JuanMartin-Cruz/ESP32-grupo-1-Etapa2/docs/TPI-Etapa2-Grupo1-Presentación.pdf

UNIVERSIDAD TECNOLÓGICA NACIONAL FRCU
INGENIERÍA EN SISTEMAS DE INFORMACIÓN

# TPI Etapa 2 Mejora de Proyecto Aire IoT

# Tecnologías para la Automatización

ALUMNOS

### Allaud, Santiago Alvarez, Noemí Carballo Peré, María Florencia Cruz, Juan Martin Ramos, Alexander

DOCENTES

### Ing. Mauro Sander Dimuro Ing. Jaime Piperno

AÑO

2026 01

# El proyecto original "Aire IoT" monitorea la calidad del aire en interiores

DESCRIPCIÓN DEL SISTEMA RECIBIDO
Monitoreo ambiental con microcontrolador ESP32 y sensor BME680
El proyecto recibido consiste en un sistema de monitoreo ambiental enfocado en la medición y visualización de parámetros de calidad del aire. Estado de Entrega: Entregado en buenas condiciones, con todas sus funcionalidades operativas y funcionando correctamente.

VARIABLES

## Medición

- Estimación de la
calidad del aire

NOTIFICACIÓN

## Alertas Locales

- Utiliza un LED
- Buzzer integrado
- Notifica condiciones
desfavorables

VISUALIZACIÓN

## Interfaz Web

- Panel para visualizar
mediciones en
tiempo real
- Consulta de historial
- Exportación de
datos en formato
CSV

LIMITACIÓN

## Intervención Manual

- Funciona como un
sistema de alerta
pasiva
- Informa cuándo
ventilar
- Requiere la acción
de una persona
UTN FRCU INGENIERÍA EN SISTEMAS DE INFORMACIÓN | TECNOLOGÍAS PARA LA AUTOMATIZACIÓN 2026

# Arquitectura de Monitoreo Comparativo: Nodo Interior vs. Exterior

Evolución del sistema original Aire IoT hacia un esquema multi-nodo centralizado para la evaluación del confort ambiental.

Dispositivo Principal

## Nodo Interior Servidor)

Centralizador de datos y servidor del panel web.

SENSORES INTEGRADOS
- BME680 Temp, humedad y IAQ
- LDR Iluminación ambiental
- KY037 Actividad sonora / ruido

Medición Remota

## Nodo Exterior Cliente)

Registra de forma independiente el ambiente exterior.

SENSORES INTEGRADOS
- DHT11 Temperatura y humedad
- MQ135 Calidad de aire estimada
- LDR & KY037 Luz y ruido

Análisis Comparativo

## Comunicación & Delta

### 5 VARIABLES EVALUADAS

Calidad de aire, temperatura, humedad, iluminación y nivel de ruido.

CÁLCULO DE DIFERENCIAS
Calcula variaciones instantáneas entre ambos espacios para diagnóstico de confort.

Nota Técnica:
Los nodos usan sensores distintos para calidad de aire BME680 vs MQ135. La calibración atenúa discrepancias guardando correcciones en memoria NVS.

# La mejora transforma el sistema en un evaluador de confort comparativo

ESTADO ANTERIOR

## Proyecto Original

OBJETIVO Y ARQUITECTURA
Monitorear calidad del aire en 1 ambiente interior con un único nodo ESP32.
SENSORES Y VARIABLES
Sensor BME680 (aire). Alertas locales por LED y buzzer. PROCESAMIENTO Y COMUNICACIÓN
Identificación de condiciones aisladas. Sin comunicación entre nodos ni calibración.
INTERFAZ Y RESULTADO
Panel web básico para datos individuales. Requiere intervención manual del usuario.

EVOLUCIÓN DEL SISTEMA

## Mejora Implementada

OBJETIVO Y ARQUITECTURA MULTINODO
Evaluación de confort comparativo. 2 nodos ESP32 Interior Servidor) y Exterior Cliente).
SENSORES Y 5 VARIABLES ANALIZADAS
Int: BME680, LDR, KY037. Ext: DHT11, MQ135, LDR, KY037. Miden aire, temp, humedad, luz y ruido.
COMUNICACIÓN Y CALIBRACIÓN NVS
Conexión Wi-Fi/HTTP. Calibración 30 muestras) con correcciones guardadas en memoria NVS.
PROCESAMIENTO E INTERFAZ INTEGRAL
Cálculo de diferencias exactas entre ambientes. Panel web comparativo en tiempo real.

# Demostración del funcionamiento de los dos nodos ESP32

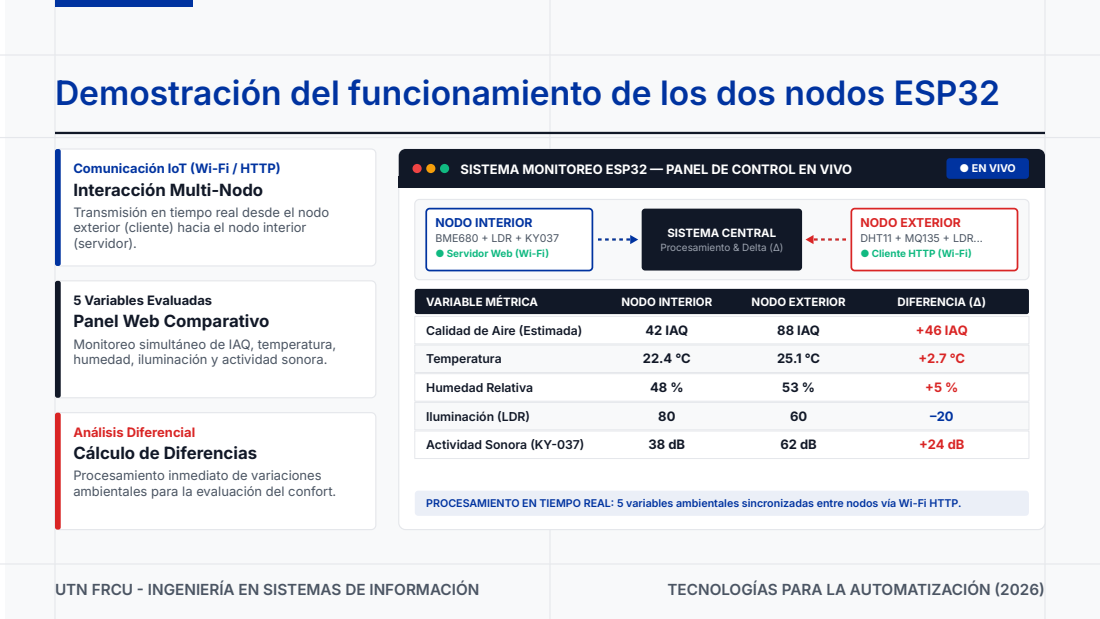
[picture p10: page 5]
SISTEMA MONITOREO ESP32 PANEL DE CONTROL EN VIVO; ● EN VIVO; SISTEMA CENTRAL Procesamiento & Delta (Δ); VARIABLE MÉTRICA; NODO INTERIOR; NODO EXTERIOR; DIFERENCIA (Δ); Calidad de Aire Estimada); 42 IAQ; 88 IAQ; 46 IAQ; Temperatura; Humedad Relativa; Actividad Sonora KY037; Iluminación LDR

Comunicación IoT Wi-Fi / HTTP
Interacción Multi-Nodo
Transmisión en tiempo real desde el nodo
exterior (cliente) hacia el nodo interior
(servidor).

NODO INTERIOR
BME680 LDR KY037
● Servidor Web Wi-Fi

NODO EXTERIOR
DHT11 MQ135 LDR...
● Cliente HTTP Wi-Fi

5 Variables Evaluadas
Panel Web Comparativo
Monitoreo simultáneo de IAQ, temperatura,
humedad, iluminación y actividad sonora.

Análisis Diferencial
Cálculo de Diferencias
Procesamiento inmediato de variaciones
ambientales para la evaluación del confort.

PROCESAMIENTO EN TIEMPO REAL 5 variables ambientales sincronizadas entre nodos vía Wi-Fi HTTP.

# Conclusiones de la Etapa 2

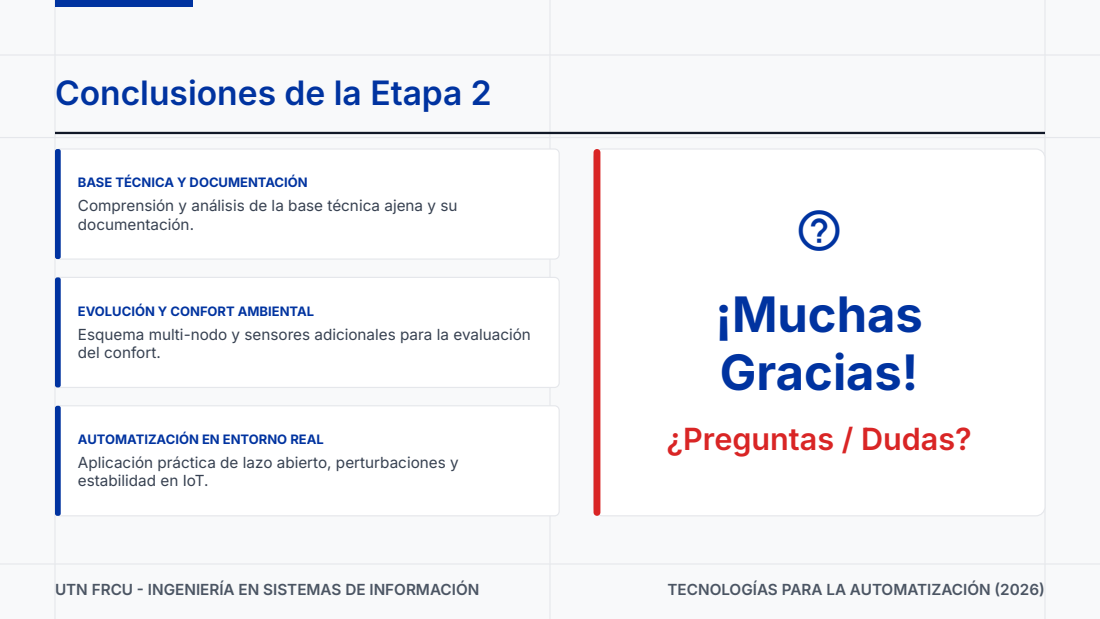
[picture p11: page 6]
¡Muchas Gracias!; ¿Preguntas / Dudas?

BASE TÉCNICA Y DOCUMENTACIÓN
Comprensión y análisis de la base técnica ajena y su
documentación.

EVOLUCIÓN Y CONFORT AMBIENTAL
Esquema multi-nodo y sensores adicionales para la evaluación
del confort.

AUTOMATIZACIÓN EN ENTORNO REAL
Aplicación práctica de lazo abierto, perturbaciones y
estabilidad en IoT.
