JuanMartin-Cruz/ESP32-grupo-1-Etapa2/firmware/Confort_Interior/web_assets.h

// GENERADO por tools/build_web.py — no editar a mano.
// Editá los archivos de web/ y corré: python3 tools/build_web.py
#pragma once
#include <Arduino.h>

const size_t INDEX_HTML_GZ_LEN = 32416;
const uint8_t INDEX_HTML_GZ[] PROGMEM = {
  0x1f, 0x8b, 0x08, 0x00, 0x00, 0x00, 0x00, 0x00, 0x02, 0xff, 0xd4, 0xbd, 0x5b, 0x73, 0x1b, 0xc7,
  0x96, 0x2e, 0xf8, 0xee, 0x5f, 0x01, 0xa2, 0xbd, 0x75, 0xaa, 0xc4, 0x02, 0x08, 0x90, 0x92, 0xac,
  0x0d, 0xb8, 0x88, 0x43, 0x4b, 0xd4, 0x65, 0x4b, 0xd4, 0x8d, 0xb4, 0x65, 0x99, 0xcd, 0xc3, 0x06,
  0x81, 0x02, 0x59, 0x66, 0xa1, 0x0a, 0x46, 0x15, 0x78, 0x11, 0x85, 0x88, 0x3e, 0xaf, 0x13, 0x31,
  0x4f, 0x3d, 0xef, 0x13, 0xfd, 0x32, 0x11, 0xfd, 0x70, 0x22, 0xe6, 0xc4, 0x79, 0x9b, 0xc7, 0xf1,
  0x3f, 0xe9, 0x5f, 0x30, 0x3f, 0x61, 0xbe, 0x6f, 0xad, 0xcc, 0xba, 0x00, 0xa0, 0x2d, 0x5f, 0x76,
  0x44, 0xb7, 0xf7, 0x16, 0x51, 0x95, 0x99, 0x95, 0xd7, 0x95, 0x2b, 0xd7, 0x3d, 0xbf, 0x5e, 0x1b,
  0x26, 0x83, 0xec, 0x7a, 0x12, 0xd4, 0xce, 0xb2, 0x71, 0xb4, 0xfd, 0xc5, 0xd7, 0xfc, 0xa9, 0x45,
  0xfd, 0xf8, 0xd4, 0xaf, 0x07, 0x69, 0x63, 0xe7, 0x5d, 0x9d, 0x69, 0x41, 0x7f, 0x88, 0x9f, 0x71,
  0x90, 0xf5, 0x6b, 0x83, 0xb3, 0xfe, 0x34, 0x0d, 0x32, 0xbf, 0x3e, 0xcb, 0x46, 0x8d, 0x87, 0x75,
  0x9b, 0x1c, 0xf7, 0xc7, 0x81, 0x5f, 0xbf, 0x08, 0x83, 0xcb, 0x49, 0x32, 0xcd, 0xea, 0xb5, 0x41,
  0x12, 0x67, 0x41, 0x8c, 0x62, 0x97, 0xe1, 0x30, 0x3b, 0xf3, 0x87, 0xc1, 0x45, 0x38, 0x08, 0x1a,
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
  0x51, 0x1f, 0x6b, 0x73, 0x12, 0x25, 0x83, 0xf3, 0xee, 0x8a, 0x6e, 0x98, 0x61, 0xb7, 0x5b, 0xad,
  0xbf, 0x74, 0xf3, 0xe9, 0xe0, 0x0b, 0x9b, 0xe9, 0x5f, 0x85, 0xe9, 0xad, 0x7d, 0x88, 0x82, 0xd3,
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
};
