JuanMartin-Cruz/ESP32-grupo-1-Etapa2/firmware/Confort_Interior/web.h

// web.h — Wi-Fi, Servidor Web HTTP, WebSocket y API para Confort_Interior
#pragma once
#include "control.h"
#include "sensor.h"

void webIniciar();
void webActualizar();
void webPublicar(const Lectura& local, const Lectura& remoto, const EstadoControl& s);
bool webObtenerRemoto(Lectura& out);
