JuanMartin-Cruz/ESP32-grupo-1-Etapa2/firmware/Confort_Interior/secrets.example.h

// secrets.example.h — Copiá este archivo como secrets.h y completá con tus datos.
#pragma once

#define WIFI_SSID "nombre-de-tu-red"
#define WIFI_PASS "clave-de-tu-red"

// Red propia que emite el ESP32 Interior si no conecta al router
#define AP_SSID "Confort_Interior"
#define AP_PASS "confort1234"
