JuanMartin-Cruz/ESP32-grupo-1-Etapa2/(commit log)

2026-10-15 Grupo 9 - Aire IoT: monitor de calidad de aire interior (ESP32 + BME680)
2026-10-15 docs(team_9): Readme según la plantilla del curso
2026-10-31 feat: add multi-node indoor air quality monitoring firmware and web dashboard for Stage 2
2026-10-31 feat: implement multi-node air quality and comfort monitoring firmware for ESP32
2026-11-02 feat: implement multi-node comfort monitoring firmware and web dashboard for ESP32
2026-11-02 feat: implement multi-node comfort monitoring firmware and web dashboard for Stage 2
2026-11-02 feat: implement firmware modules for sensors, control, and web interface
2026-11-03 feat: implement firmware and web interface for exterior and interior comfort ESP32 nodes
2026-11-03 fix(security): untrack secrets.h and replace real WiFi credentials in examples
    The new firmware folders (Confort_Interior, Confort_Exterior) were not covered by the old .gitignore rule, so both secrets.h files were committed with a real SSID and password. The .example.h files also carried the same credentials.
    - .gitignore now covers firmware/**/secrets.h
    - secrets.h removed from the index (kept locally)
    - Examples now use placeholder values
    [secrets.example.h]
2026-11-03 docs(etapa2): align readme with current firmware behaviour
    - Remote payload documented with its real 9 fields
    - Add remote link timeout (REMOTO_TIMEOUT_MS, 15 s)
    - Add endpoint table for the interior node
    - Document exact library versions and the ESP32Async requirement
    - Note that the interior node uses Adafruit BME680, not BSEC2
    - Explain how each node derives its IAQ and why the values are not directly comparable
    - Warn that secrets.h must never be committed
2026-11-03 fix(exterior): decode DHT11 and stop hiding sensor failures
    The field sensor on the exterior node is a DHT11, not a DHT22. Decoding it with the 16-bit 0.1-resolution format produced 1562 % RH and 717 C, which the range guard rejected, leaving temp/hum frozen at the 20.0/50.0 defaults with no message on the serial monitor.
    - Rename the driver and class from DHT22 to DHT11
    - Decode one 8-bit integer per magnitude; the decimal bytes are junk on this clone
    - Log the active sensor once and warn every 10 s when a read is rejected
    - Update readme, dashboard tooltip and add a sensor-resolution note
    - Add tools/diagnostico_dht (isolated sensor probe) and tools/monitor_serial.ps1 (serial monitor with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
    [Confort_Exterior.ino, config.h, dht11.cpp, dht11.h, diagnostico_dht.ino, sensor.cpp, sensor.h]
2026-11-03 feat: implement firmware for outdoor comfort sensor node with DHT11, MQ-135, LDR, and KY-037
2026-11-03 feat(interior): add cross-sensor calibration for the exterior node
    The interior node measures with a BME680 and the exterior with a DHT11 and an MQ-135, so their readings are not directly comparable.
    Add an additive correction computed by placing both nodes in the same environment:
    - calibracion.h/.cpp: pure module with the correction and the sample accumulator
    - web.cpp: correction applied when the remote payload arrives; the raw value is
    kept separately so calibration is not fed with already-corrected data
    - Endpoints: GET /api/calibracion, POST /api/calibracion/{iniciar,aplicar,reset}
    - Offsets persisted in NVS and exposed in /api/current
    - Native tests for the correction and the accum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
    [calibracion.cpp, calibracion.h, web.cpp]
2026-11-03 feat(web): expose uncorrected exterior readings and toggle in the dashboard
    - /api/current, /ws: add pasillo_crudo (raw exterior) and delta_crudo
    - Dashboard: checkbox 'Ver sin calibrar' switches the exterior series and deltas
    between corrected and raw values
    - Show the active calibration offsets (or the running progress) under the header
    - Mock server emits pasillo_crudo, delta_crudo and calibracion with a simulated bias
    - Regenerate web_assets.h
    [web.cpp, web_assets.h]
2026-11-10 docs: add exterior and interior schematic images
